sangeet0107-hash/hybrid-flow-/docs/wiring/3-trimpots.png

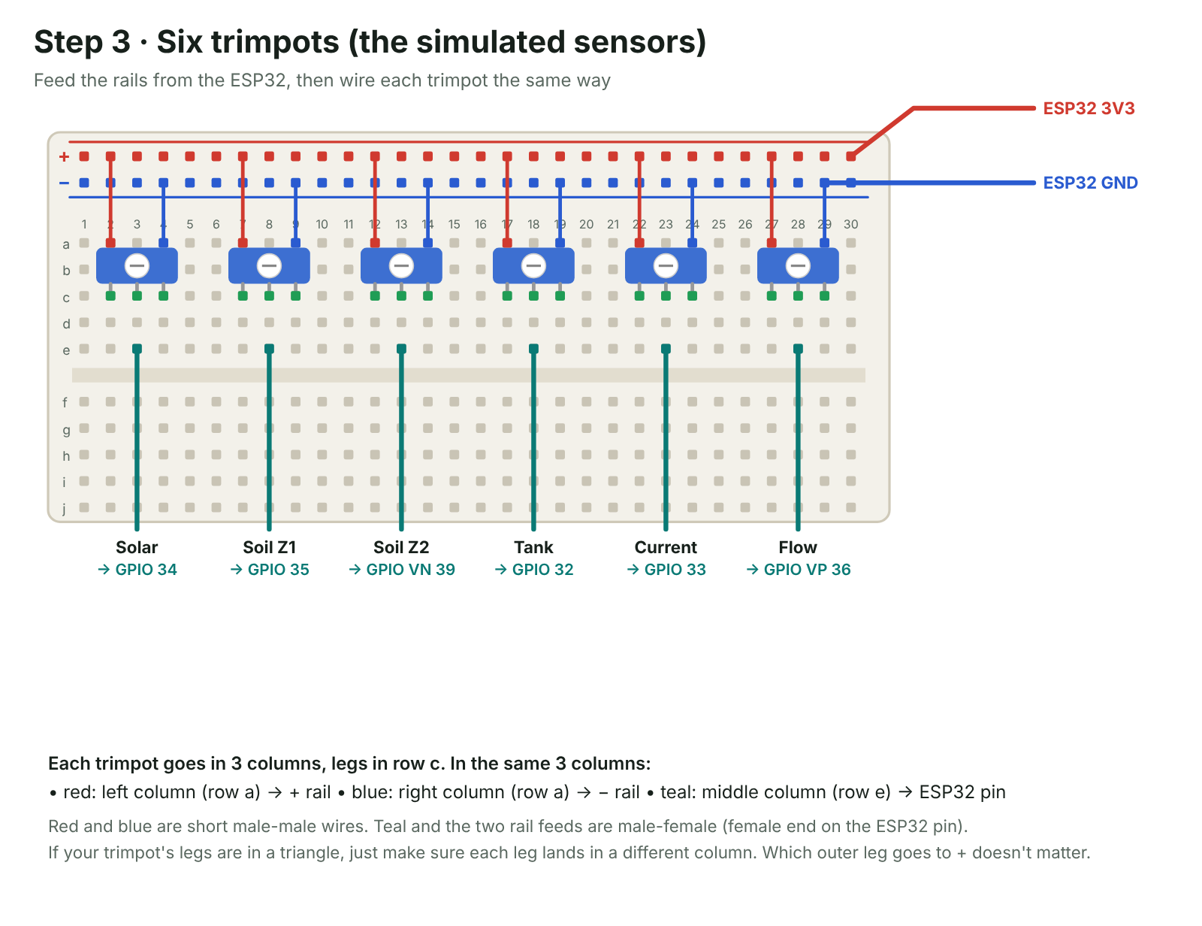
docs/wiring/3-trimpots.png
