sangeet0107-hash/hybrid-flow-/docs/wiring/4-relay-buzzer.png

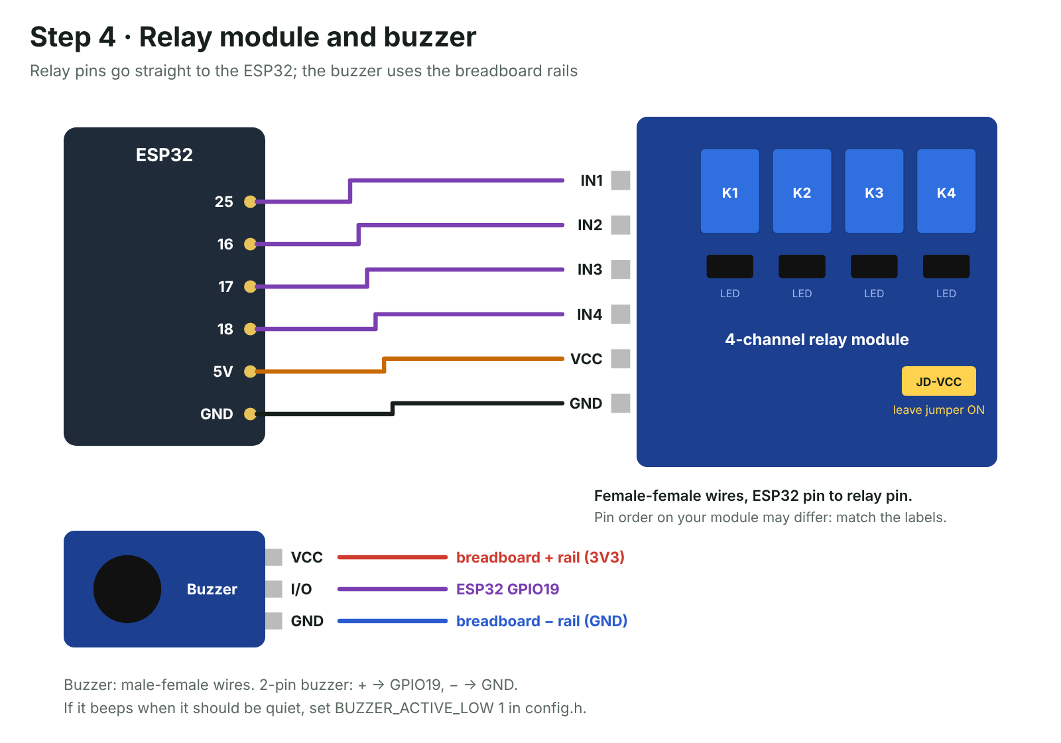
docs/wiring/4-relay-buzzer.png
