sangeet0107-hash/hybrid-flow-/(commit log)

2026-10-15 Add ESP32 firmware and shared behaviour tests
    Control logic (solar priority, critical-only grid fallback, break-before-make
    changeover, dry-run/over-current/no-flow trips, metering) is free of Arduino
    dependencies and runs against 15 scenarios on a PC. Sensors, Firebase uplink
    with offline buffering on core 0, and a host compile check of the sketch.
    Claude-Session: https://claude.ai/code/session_01CnvCThReiYdvLzNsWTigUA
2026-10-15 Add Firebase rules and Python device emulator
    The emulator runs the same control logic against a farm model and publishes
    to the Realtime Database exactly like the ESP32, including test scenarios and
    a guided demo.
    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
2026-10-15 Add Streamlit dashboard
    Built-in simulator or Firebase source; status cards, live single-line diagram,
    sensor tiles with thresholds, Plotly trends, energy and water benchmark, event
    log, operator commands, test scenarios and guided demo.
    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
2026-10-15 Add Wokwi simulation and PlatformIO builds
    Full circuit in diagram.json on the review's pin table; the wokwi environment
    builds with WOKWI_SIM so pots stand in for the current and flow sensors.
    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
2026-10-15 Make test scenarios visible even when the pump is idle
    Pump-fault scenarios start a watering run if none is active so the trip
    happens; cloud cover makes Zone 2 critical so the grid changeover shows;
    tank overfill takes effect at once. The Streamlit sidebar now confirms each
    click with what to expect and the page lists active test conditions.
    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
2026-10-15 Add bench build: knobs stand in for the sensors
    New default firmware profile (SIM_INPUTS 1) reads six potentiometers in
    place of the solar divider, soil probes, tank level, pump current and flow,
    in the same units and thresholds as the field build. The pump runs on relay
    channel 4, DHT22 is optional, and buzzer and relay polarity are configurable.
    SIM_INPUTS 0 keeps the full sensor build. The Wokwi circuit now matches the
    bench wiring, the dashboard labels knob inputs, and docs/bench-wiring.png
    shows the wiring.
    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
2026-10-15 Add step-by-step wiring pictures for the bench build
    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
2026-10-15 Demo-ready: dashboard reads the ESP32 over USB and Wokwi, Streamlit-only frontend
    - Firmware prints the live state and events as JSON lines on the serial
    port; the Streamlit dashboard reads them over the USB cable, so the demo
    needs no Wi-Fi or Firebase. secrets.h is now optional.
    - Wokwi for VS Code shares the simulated serial port on localhost:4000 and
    the dashboard connects to it the same way.
    - Boot-time relay self-test (relays 1-4 click in order) and serial commands
    to invert relay or buzzer logic, saved on the board.
    - Sidebar: ESP32 over USB, Wokwi simulator, built-in simulator, Firebase,
    with a knob demo guide for the board.
    - Remove the HTML/JS dashboard; Streamlit is the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
2026-10-28 Read the real sensors on the bench, keep knobs for solar, current and flow
    Each input now has its own switch in config.h (REAL_SOLAR, REAL_SOIL,
    REAL_TANK, REAL_DHT22, REAL_LDR, REAL_CURRENT, REAL_FLOW). The default
    build reads the capacitive soil probes, the HC-SR04 with the float switch,
    the DHT22 and the LDR; knobs stay for solar voltage, pump current and flow.
    SIM_INPUTS=1 still gives the six-knob bench (and Wokwi), SIM_INPUTS=0 the
    field build.
    - HC-SR04: bench range 5-50 cm, longer echo timeout, keeps the last
    reading through short runs of missed echoes
    - Serial command c prints raw soil mV, tank cm, LDR, float and DHT22
    readings for calibration
    - Clear compile error if the DHT li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
2026-10-28 Fix DHT22 build in the Arduino IDE: include DHT.h directly
    The Arduino IDE adds a library to the build only when it sees a plain
    #include for it. Guarding the include with __has_include() meant the IDE
    never looked, so the build stopped with "install DHT sensor library" even
    with the library installed.
    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
2026-10-28 Clear "tank full" from the float switch when the level sensor has no reading
    Tank full only cleared once the ultrasonic read below 90 %. With the HC-SR04
    missing or out of range (NaN), one float-switch blip latched it for good and
    irrigation never restarted. Now, with no level reading, the float switch
    alone decides. Same change in the Python controller, plus a scenario test.
    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
